RoseDaggerDev/GBAWii3-Boards/EastECHO/KiCad/Export/EastECHO-Edge_Cuts.dxf

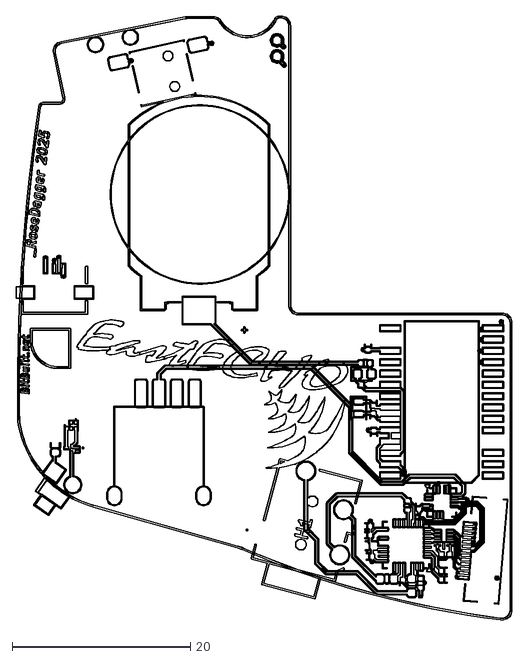
[picture p12: CAD file, 2025-09-09]
EastECHO/KiCad/Export/EastECHO-Edge_Cuts.dxf
55.6 x 67.7
