RoseDaggerDev/GBAWii3-Boards/EastECHO/KiCad/Outline.dxf

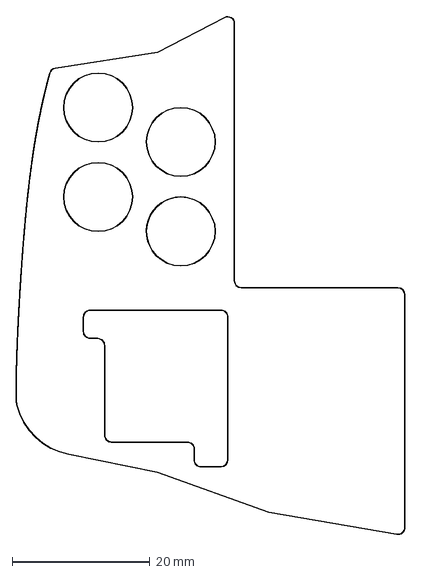
[picture p13: CAD file, 2025-09-04]
EastECHO/KiCad/Outline.dxf
56.5 x 75.3 mm
