RoseDaggerDev/GBAWii3-Boards/GhostPAW/KiCad/MelonLORD.dxf

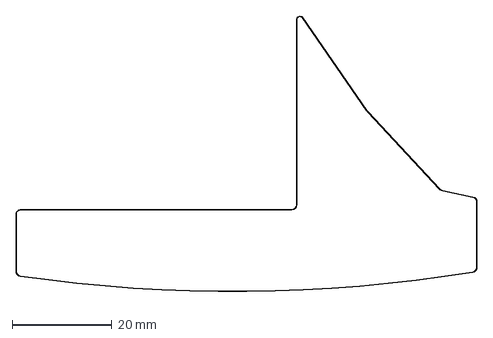
[picture p14: CAD file, 2025-09-04]
GhostPAW/KiCad/MelonLORD.dxf
92.4 x 56.5 mm
