RoseDaggerDev/GBAWii3-Boards/MelonLORD/KiCad/Outline.dxf

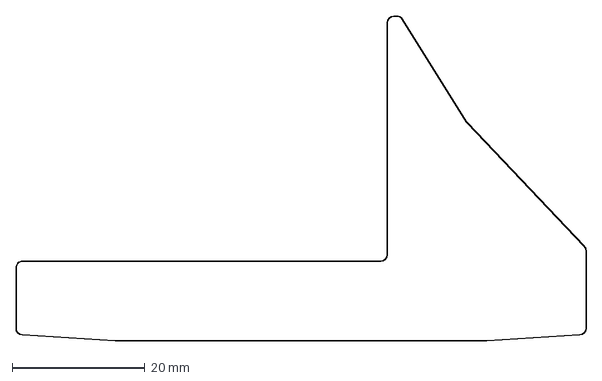
[picture p15: CAD file, 2025-09-04]
MelonLORD/KiCad/Outline.dxf
86.0 x 49.0 mm
