RoseDaggerDev/GBAWii3-Boards/EastECHO/KiCad/EastECHO.step

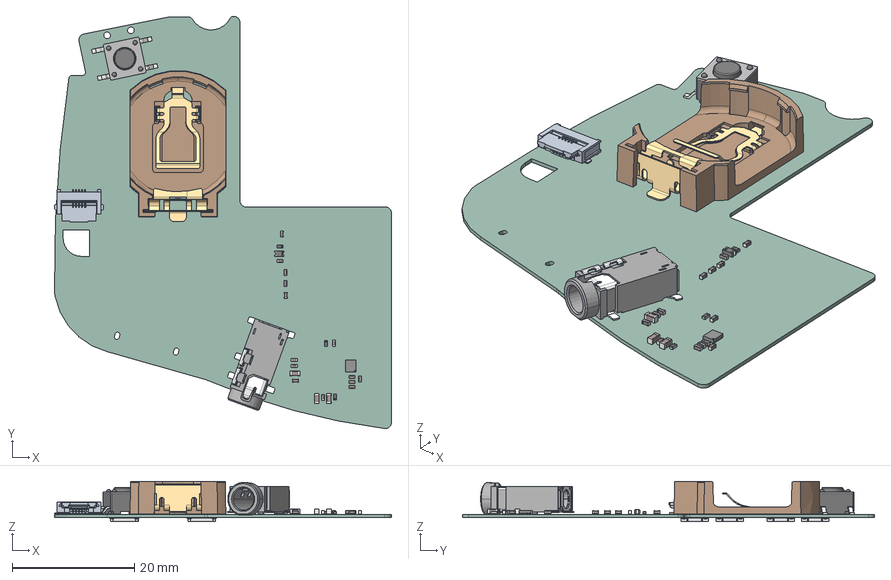
[picture p16: CAD file, 2025-09-04]
EastECHO/KiCad/EastECHO.step
55.2 x 67.5 x 6.58 mm
C_0603_1608Metric x 3
R_0402_1005Metric x 3
C_0402_1005Metric x 14
SJ2-35364B-SMT-TR
TXU0104RUTR
SW_Push_1P1T_NO_E-Switch_TL3301NxxxxxG
D_0603_1608Metric
TL3315NF100Q x 4
EastECHO_PCB
