RoseDaggerDev/GBAWii3-Boards/GhostPAW/KiCad/Export/GhostPAW-Edge_Cuts.dxf

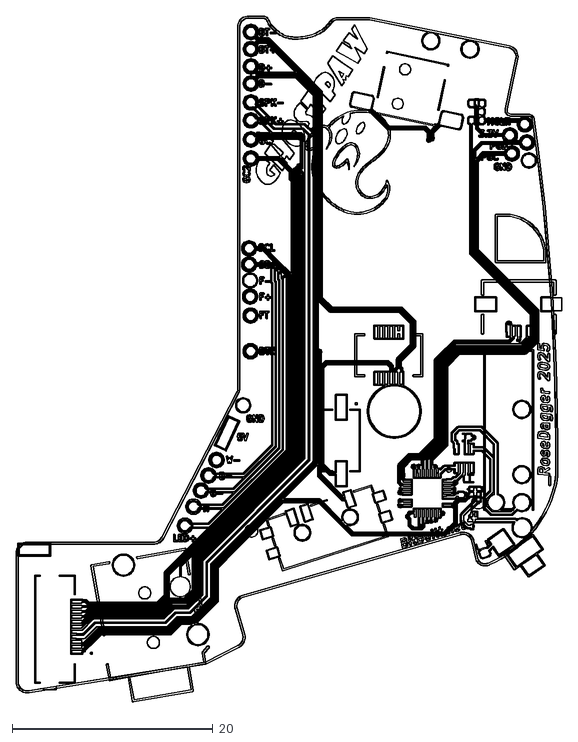
[picture p17: CAD file, 2025-09-09]
GhostPAW/KiCad/Export/GhostPAW-Edge_Cuts.dxf
54.4 x 68.3
