RoseDaggerDev/GBAWii3-Boards/GhostPAW/KiCad/Outline.dxf

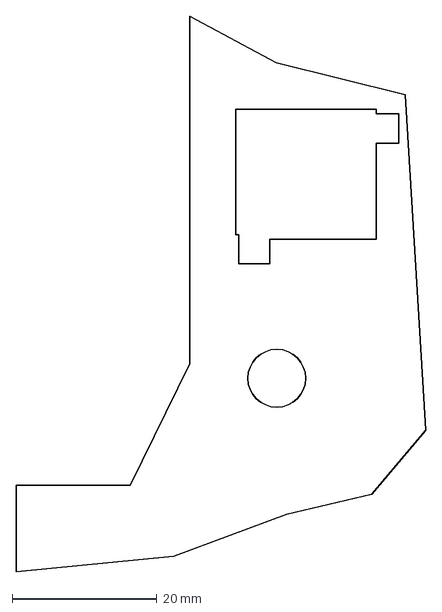
[picture p18: CAD file, 2025-09-04]
GhostPAW/KiCad/Outline.dxf
56.5 x 76.7 mm
