RoseDaggerDev/GBAWii3-Boards/MelonLORD/KiCad/Export/MelonLORD-Edge_Cuts.dxf

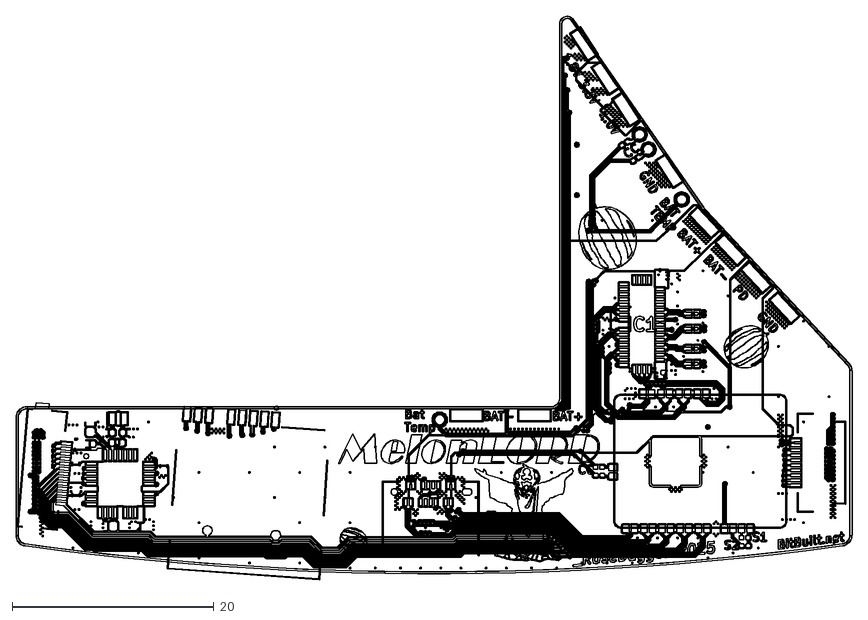
[picture p19: CAD file, 2025-09-04]
MelonLORD/KiCad/Export/MelonLORD-Edge_Cuts.dxf
82.9 x 55.9
