RoseDaggerDev/GBAWii3-Boards/(list of files, cad)

Other CAD files:
GhostPAW/KiCad/Export/GhostPAW.stl
MelonLORD/KiCad/Export/MelonLORD.stl
EastECHO/KiCad/EastECHO.stl
EastECHO/KiCad/Export/EastECHO.stl
GhostPAW/KiCad/Export/GhostPAW-B_Mask.dxf
GhostPAW/KiCad/GhostPAW.stl
MelonLORD/KiCad/MelonLORD-Edge_Cuts.dxf
MelonLORD/KiCad/MelonLORD.stl
