RoseDaggerDev/GBAWii3-Boards/EastECHO/KiCad/Export/EastECHO-Edge_Cuts.pdf

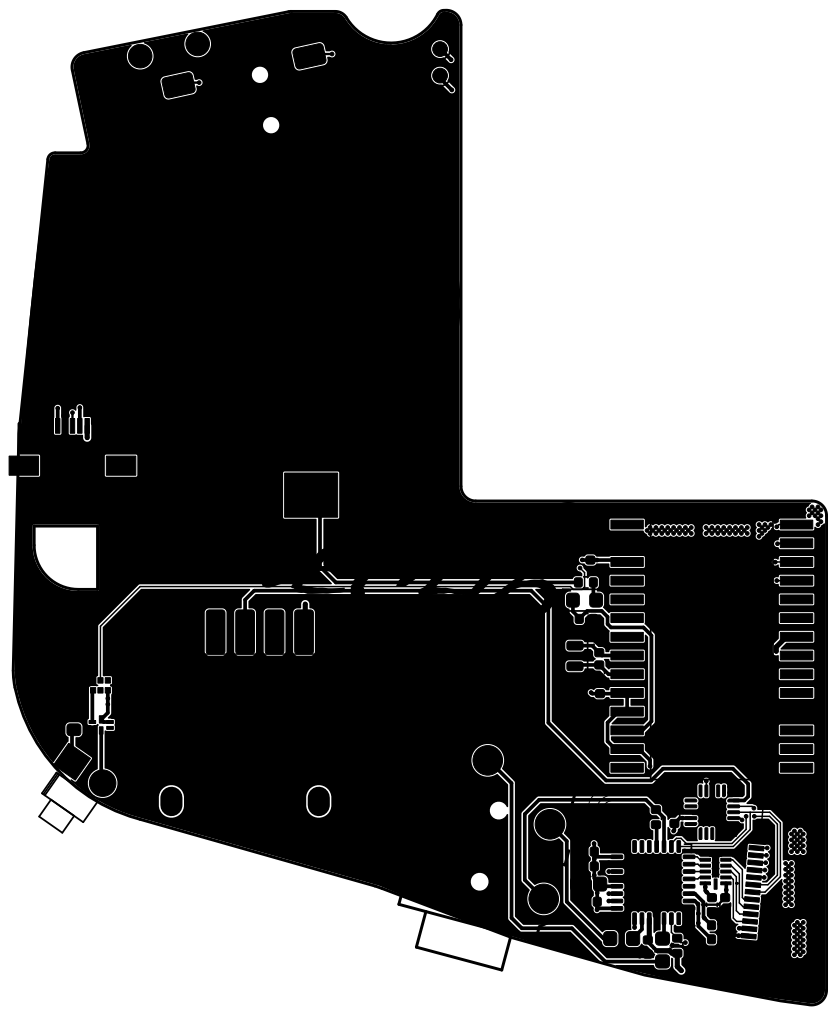
[picture p20: page 1]
