RoseDaggerDev/GBAWii3-Boards/EastECHO/KiCad/Export/EchoEAST.pdf

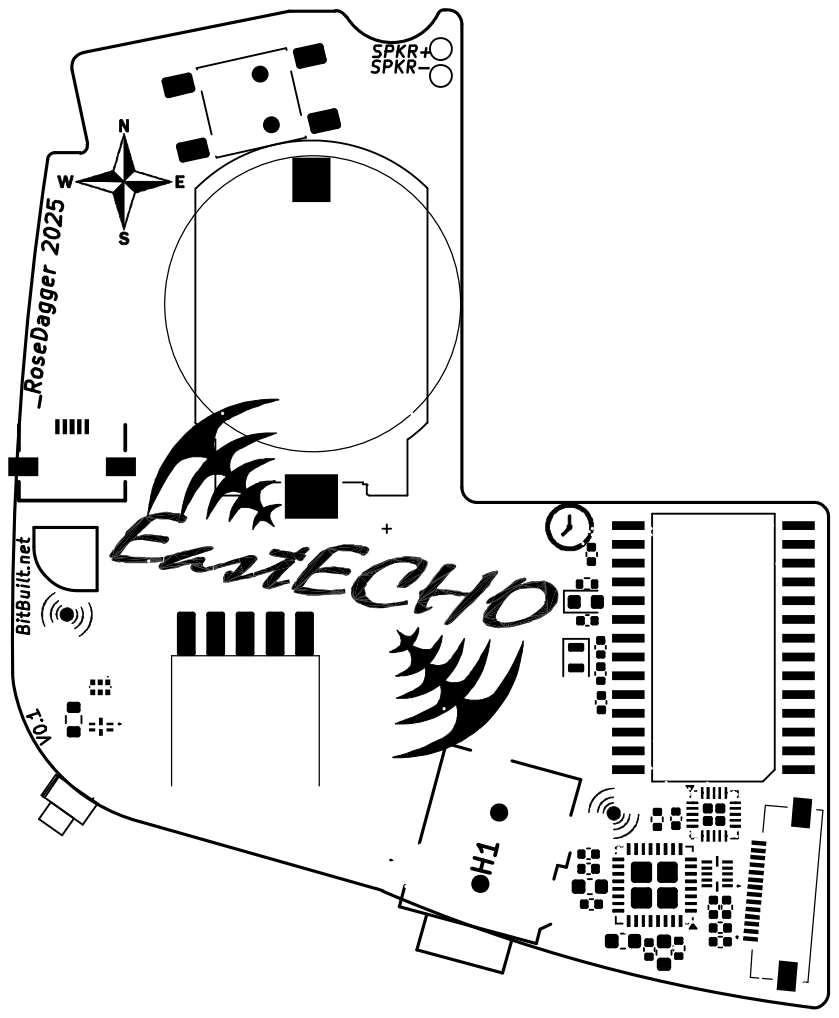
[picture p21: page 1]
