RoseDaggerDev/GBAWii3-Boards/GhostPAW/KiCad/Export/GhostPAW.pdf

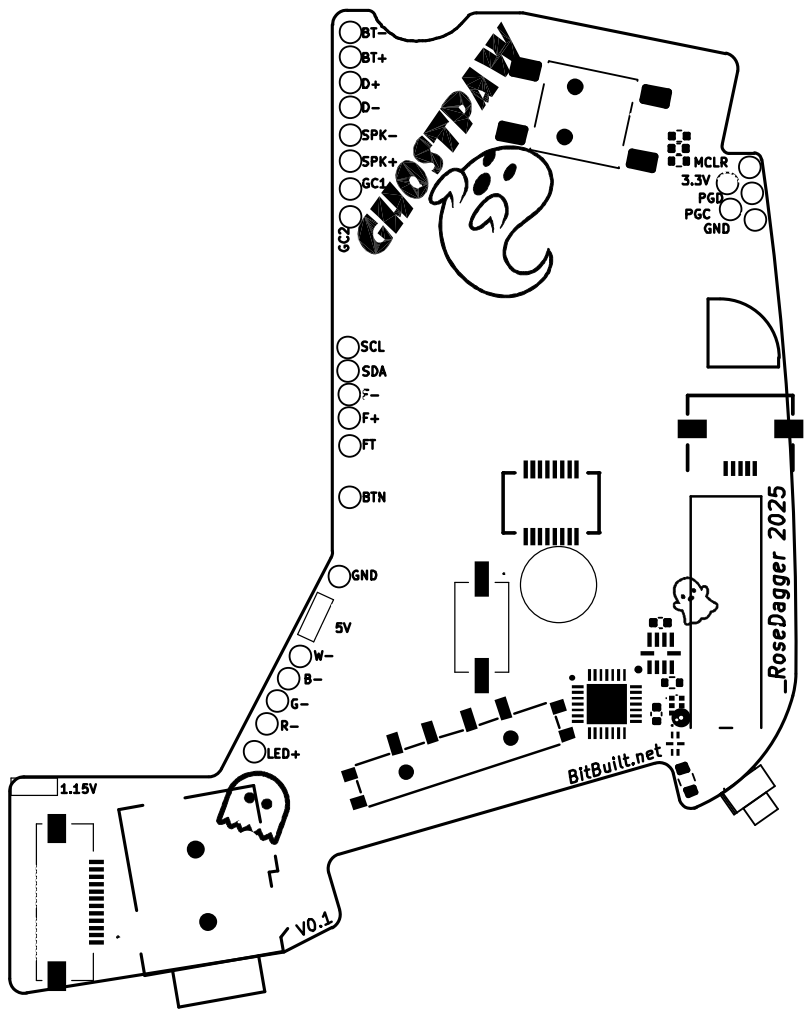
[picture p22: page 1]
