RoseDaggerDev/GBAWii3-Boards/MelonLORD/KiCad/Export/MelonLORD.pdf

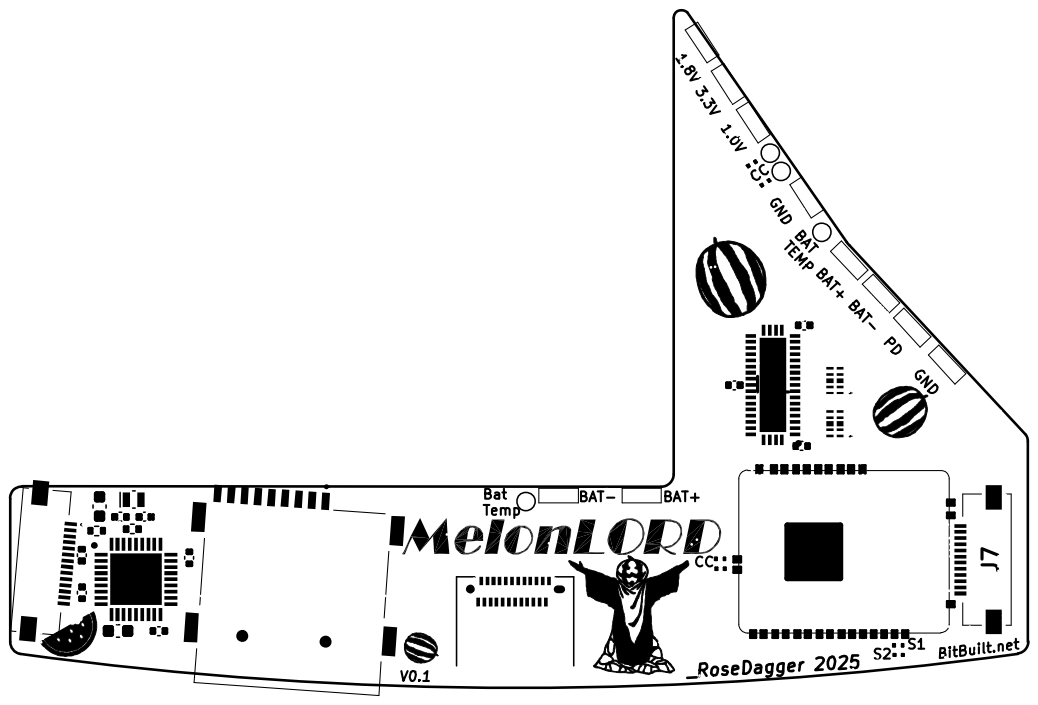
[picture p23: page 1]
