RoseDaggerDev/GBAWii3-Boards/EastECHO/KiCad/EastECHO.kicad_sch

## KiCad design EastECHO/KiCad/EastECHO.kicad_sch (2025-09-04)

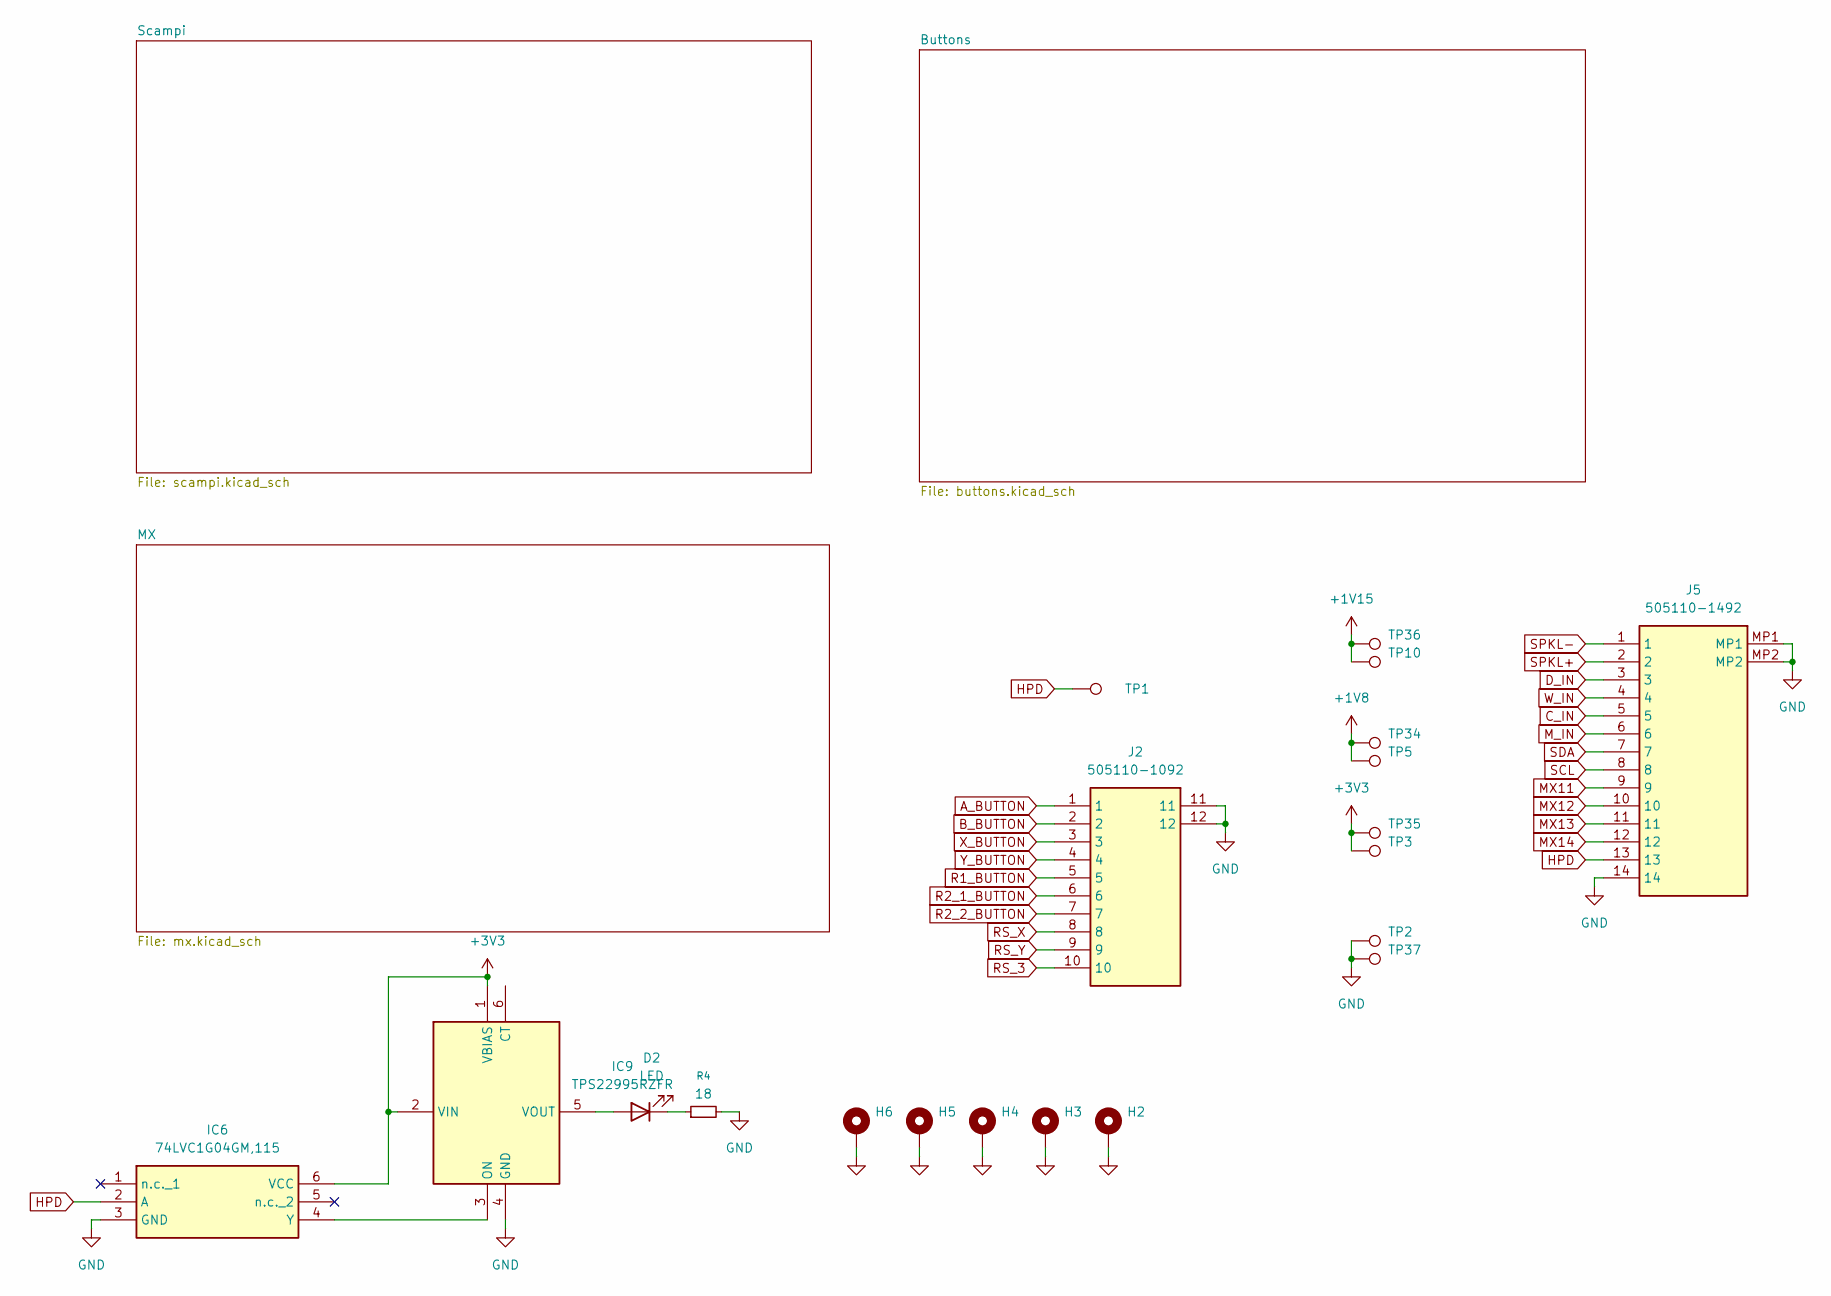
[picture p24: schematic EastECHO.kicad_sch]

Parts:
D2: LED; LED_D1.8mm_W1.8mm_H2.4mm_Horizontal_O1.27mm_Z8.2mm
H2, H3, H4, H5, H6: MountingHole_Pad; MountingHole_2.2mm_M2_DIN965_Pad
IC6: 74LVC1G04GM,115; PESD3V3L5UF115; Mouser Part Number 771-LVC1G04GM115
IC9: TPS22995RZFR; Mouser Part Number 595-TPS22995RZFR
J2: 505110-1092; 5051101092; Mouser Part Number 538-505110-1092
J5: 505110-1492; 5051101492; Mouser Part Number 538-505110-1492
R4: 18; R_0603_1608Metric
TP1: SPKL-; TestPoint_Pad_D1.0mm
TP2, TP3, TP5, TP10, TP34, TP35, TP36, TP37: TestPoint; TestPoint_Pad_3x1.0mm

Connections:
+1V8: TP5.1, TP34.1
+1V15: TP10.1, TP36.1
+3V3: IC6.6 (VCC), IC9.1 (VBIAS), IC9.2 (VIN), TP3.1, TP35.1
A_BUTTON: J2.1
B_BUTTON: J2.2
C_IN: J5.5
D_IN: J5.3
GND: H2.1, H3.1, H4.1, H5.1, H6.1, IC6.3 (GND), IC9.4 (GND), J2.11, J2.12, J5.14, J5.MP1, J5.MP2, R4.2, TP2.1, TP37.1
HPD: IC6.2 (A), J5.13, TP1.1
MX11: J5.9
MX12: J5.10
MX13: J5.11
MX14: J5.12
M_IN: J5.6
unnamed: D2.1 (K), R4.1
unnamed: D2.2 (A), IC9.5 (VOUT)
unnamed: IC6.4 (Y), IC9.3 (ON)
R1_BUTTON: J2.5
R2_1_BUTTON: J2.6
R2_2_BUTTON: J2.7
RS_3: J2.10
RS_X: J2.8
RS_Y: J2.9
SCL: J5.8
SDA: J5.7
SPKL+: J5.2
SPKL-: J5.1
W_IN: J5.4
X_BUTTON: J2.3
Y_BUTTON: J2.4
