RoseDaggerDev/GBAWii3-Boards/EastECHO/KiCad/buttons.kicad_sch

## KiCad design EastECHO/KiCad/buttons.kicad_sch (2025-09-04)

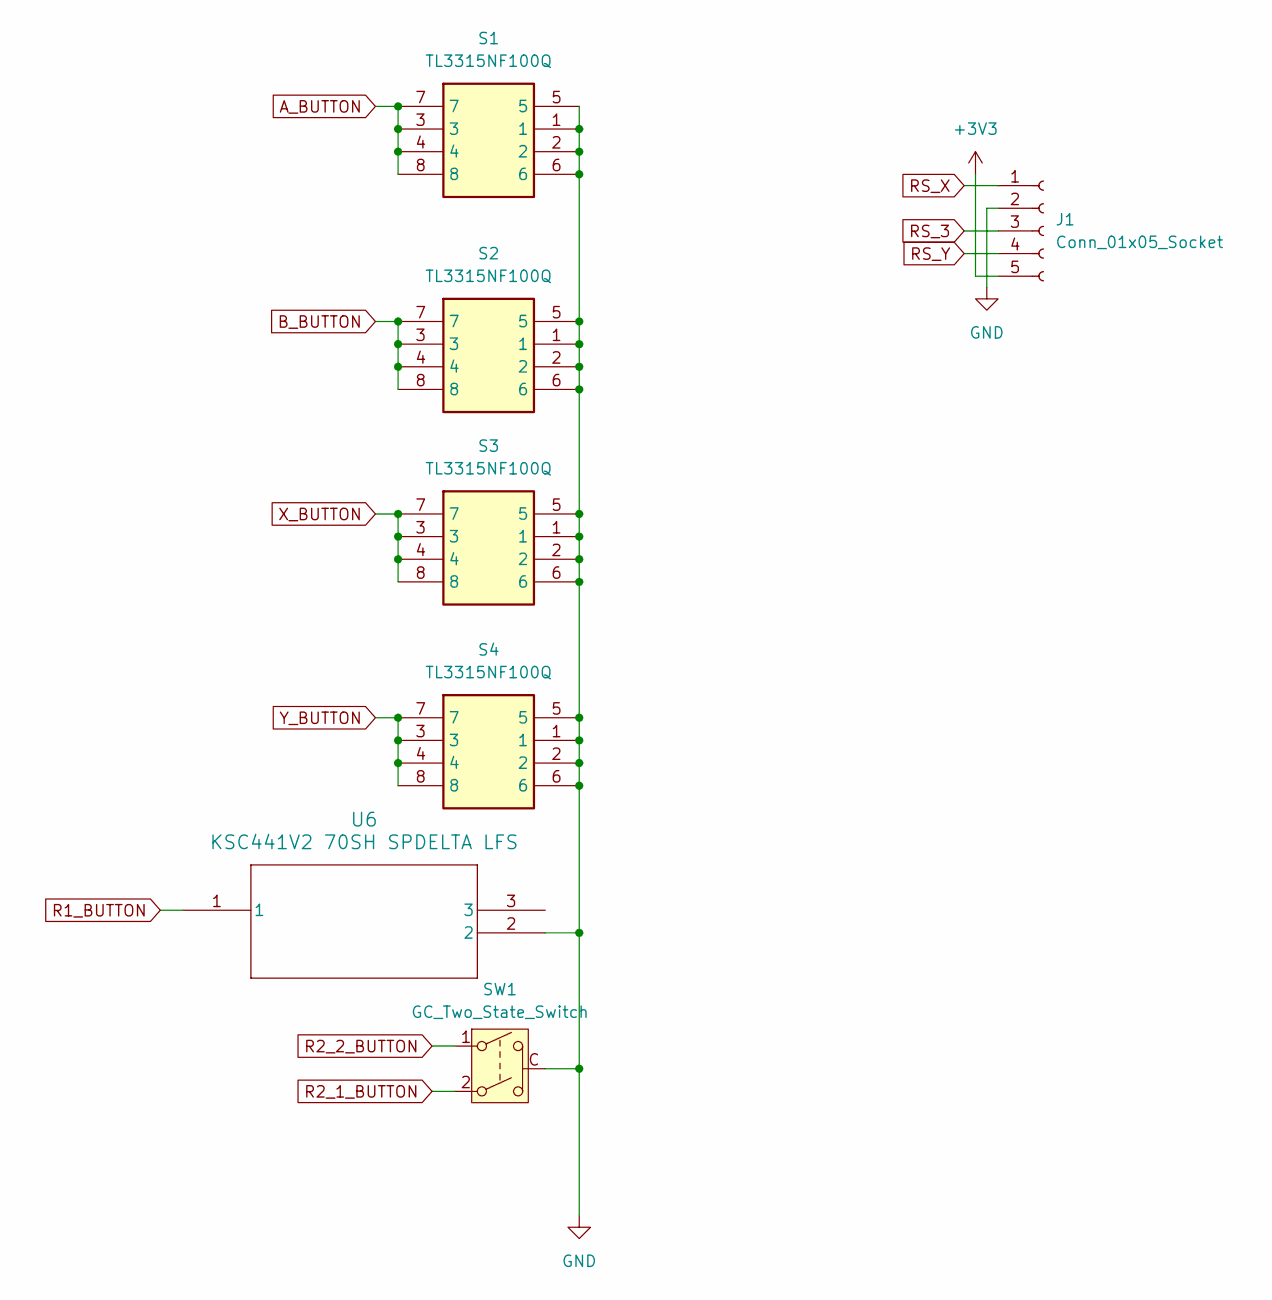
[picture p25: schematic buttons.kicad_sch]

Parts:
J1: Conn_01x05_Socket; 5051100592
S1, S2, S3, S4: TL3315NF100Q; Mouser Part Number 612-TL3315NF100Q
SW1: GC_Two_State_Switch; GC_Two_state_switch
U6: KSC441V2 70SH SPDELTA LFS; SW3_KSC441V2

Connections:
+3V3: J1.5
A_BUTTON: S1.3, S1.4, S1.7, S1.8
B_BUTTON: S2.3, S2.4, S2.7, S2.8
GND: J1.2, S1.1, S1.2, S1.5, S1.6, S2.1, S2.2, S2.5, S2.6, S3.1, S3.2, S3.5, S3.6, S4.1, S4.2, S4.5, S4.6, SW1.C, U6.2
R1_BUTTON: U6.1
R2_1_BUTTON: SW1.2
R2_2_BUTTON: SW1.1
RS_3: J1.3
RS_X: J1.1
RS_Y: J1.4
X_BUTTON: S3.3, S3.4, S3.7, S3.8
Y_BUTTON: S4.3, S4.4, S4.7, S4.8
