RoseDaggerDev/GBAWii3-Boards/EastECHO/KiCad/mx.kicad_sch

## KiCad design EastECHO/KiCad/mx.kicad_sch (2025-09-04)

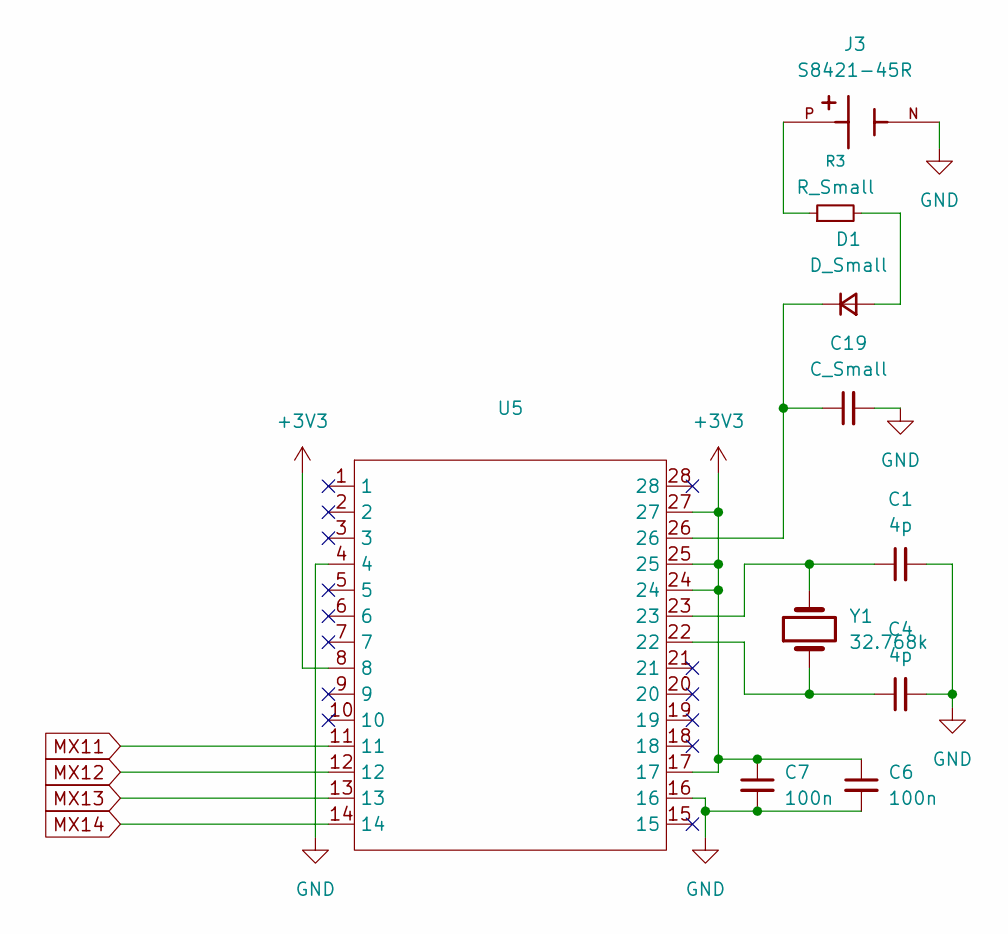
[picture p26: schematic mx.kicad_sch]

Parts:
C1, C4: 4p; C_0402_1005Metric
C6, C7: 100n; C_0402_1005Metric
C19: C_Small; C_0402_1005Metric
D1: D_Small; D_0603_1608Metric
J3: S8421-45R; HARWIN_S8421-45R; PARTREV 7
R3: R_Small; R_0402_1005Metric
U5: MX_CHIP
Y1: 32.768k; Crystal_SMD_2012-2Pin_2.0x1.2mm

Connections:
+3V3: C6.1, C7.1, U5.8, U5.17, U5.24, U5.25, U5.27
GND: C1.2, C4.2, C6.2, C7.2, C19.2, J3.N, U5.4, U5.16
MX11: U5.11
MX12: U5.12
MX13: U5.13
MX14: U5.14
unnamed: C1.1, U5.23, Y1.2
unnamed: C4.1, U5.22, Y1.1
unnamed: C19.1, D1.1 (K), U5.26
unnamed: D1.2 (A), R3.2
unnamed: J3.P, R3.1
