RoseDaggerDev/GBAWii3-Boards/EastECHO/KiCad/scampi.kicad_sch

## KiCad design EastECHO/KiCad/scampi.kicad_sch (2025-09-04)

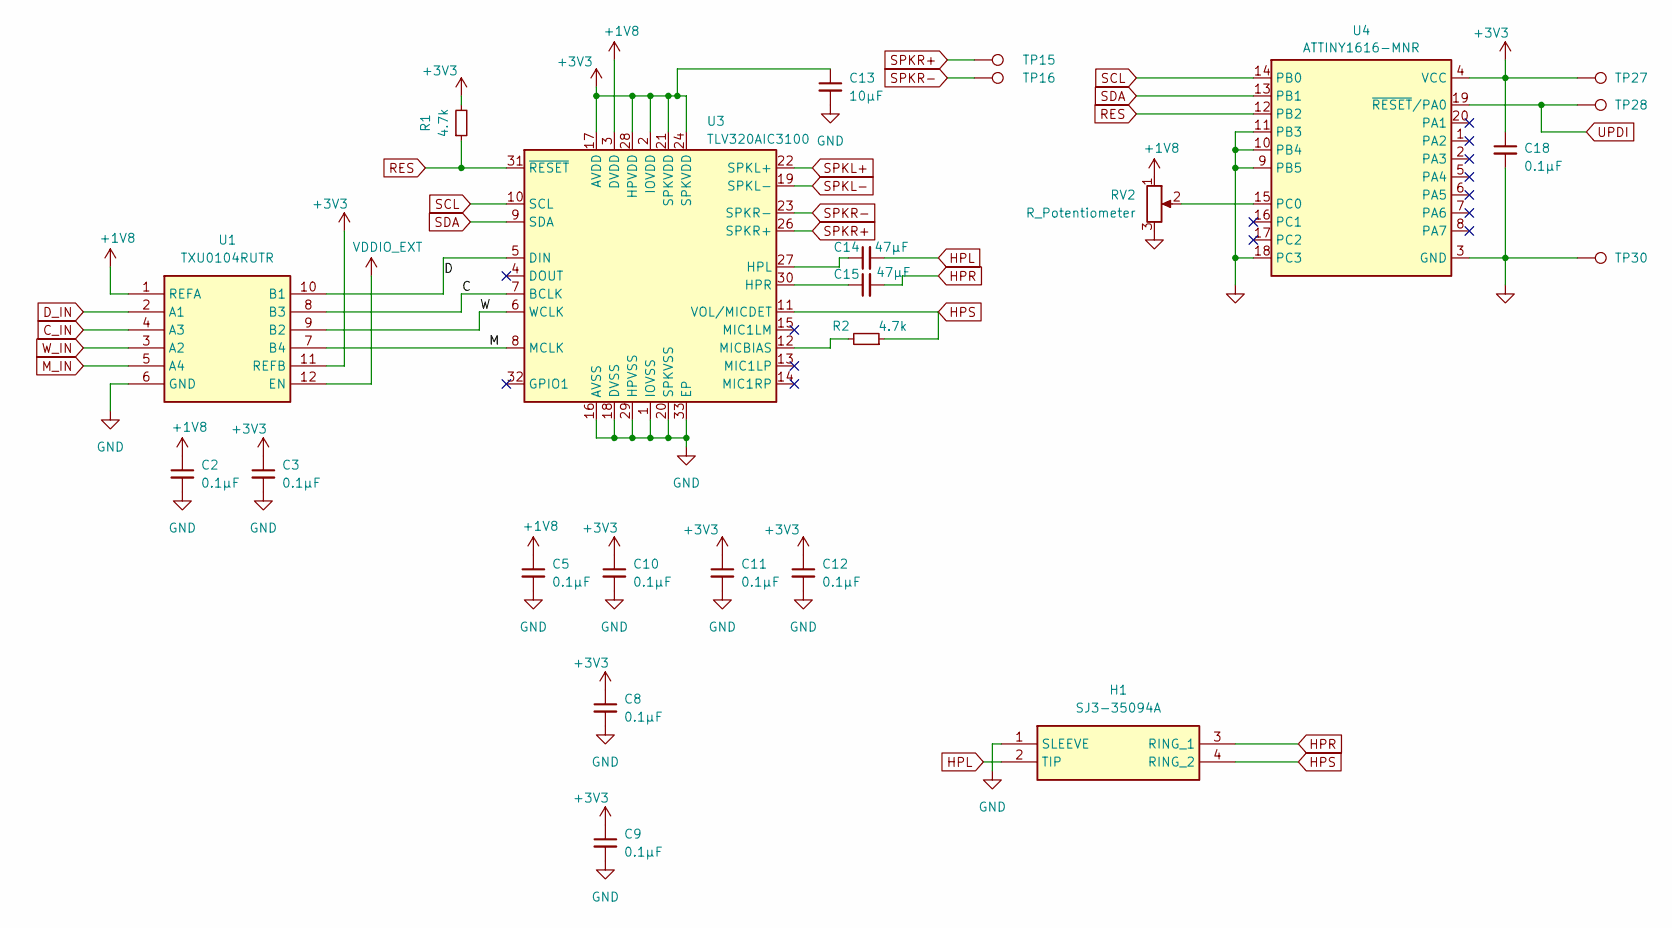
[picture p27: schematic scampi.kicad_sch]

Parts:
C2, C3, C5, C8, C9, C10, C11, C12, C18: 0.1µF; C_0402_1005Metric
C13: 10µF; C_0603_1608Metric
C14, C15: 47µF; C_0603_1608Metric
H1: SJ3-35094A; SJ335094A; Mouser Part Number 179-SJ3-35094A
R1, R2: 4.7k; R_0402_1005Metric
RV2: R_Potentiometer; B103_Potentiometer
TP15: SPKR-; TestPoint_Pad_D1.0mm
TP16: SPKR+; TestPoint_Pad_D1.0mm
TP27: 3.3V; TestPoint_Pad_D1.0mm
TP28: UPDI; TestPoint_Pad_D1.0mm
TP30: GND; TestPoint_Pad_D1.0mm
U1: TXU0104RUTR; Mouser Part Number TXU0104RUTR
U3: TLV320AIC3100; VQFN-32-1EP_5x5mm_P0.5mm_EP3.5x3.5mm
U4: ATTINY1616-MNR; VQFN-20-1EP_3x3mm_P0.4mm_EP1.7x1.7mm

Connections:
+1V8: C2.1, C5.1, RV2.1, U1.1 (REFA), U3.3 (DVDD)
+3V3: C3.1, C8.1, C9.1, C10.1, C11.1, C12.1, C13.1, C18.1, R1.2, TP27.1, U1.11 (REFB), U3.2 (IOVDD), U3.17 (AVDD), U3.21 (SPKVDD), U3.24 (SPKVDD), U3.28 (HPVDD), U4.4 (VCC)
C: U1.8 (B3), U3.7 (BCLK)
C_IN: U1.4 (A3)
D: U1.10 (B1), U3.5 (DIN)
D_IN: U1.2 (A1)
GND: C2.2, C3.2, C5.2, C8.2, C9.2, C10.2, C11.2, C12.2, C13.2, C18.2, H1.1 (SLEEVE), RV2.3, TP30.1, U1.6 (GND), U3.1 (IOVSS), U3.16 (AVSS), U3.18 (DVSS), U3.20 (SPKVSS), U3.25 (SPKVSS), U3.29 (HPVSS), U3.33 (EP), U4.3 (GND), U4.9 (PB5), U4.10 (PB4), U4.11 (PB3), U4.18 (PC3), U4.21 (GND)
HPL: C14.2, H1.2 (TIP)
HPR: C15.2, H1.3 (RING_1)
HPS: H1.4 (RING_2), R2.1, U3.11 (VOL/MICDET)
M: U1.7 (B4), U3.8 (MCLK)
M_IN: U1.5 (A4)
unnamed: C14.1, U3.27 (HPL)
unnamed: C15.1, U3.30 (HPR)
unnamed: R2.2, U3.12 (MICBIAS)
unnamed: RV2.2, U4.15 (PC0)
RES: R1.1, U3.31 (~RESET), U4.12 (PB2)
SCL: U3.10 (SCL), U4.14 (PB0)
SDA: U3.9 (SDA), U4.13 (PB1)
SPKL+: U3.22 (SPKL+)
SPKL-: U3.19 (SPKL-)
SPKR+: TP15.1, U3.26 (SPKR+)
SPKR-: TP16.1, U3.23 (SPKR-)
UPDI: TP28.1, U4.19 (~RESET/PA0)
VDDIO_EXT: U1.12 (EN)
W: U1.9 (B2), U3.6 (WCLK)
W_IN: U1.3 (A2)
