RoseDaggerDev/GBAWii3-Boards/GhostPAW/KiCad/GC2Plus.kicad_sch

## KiCad design GhostPAW/KiCad/GC2Plus.kicad_sch (2025-09-04)

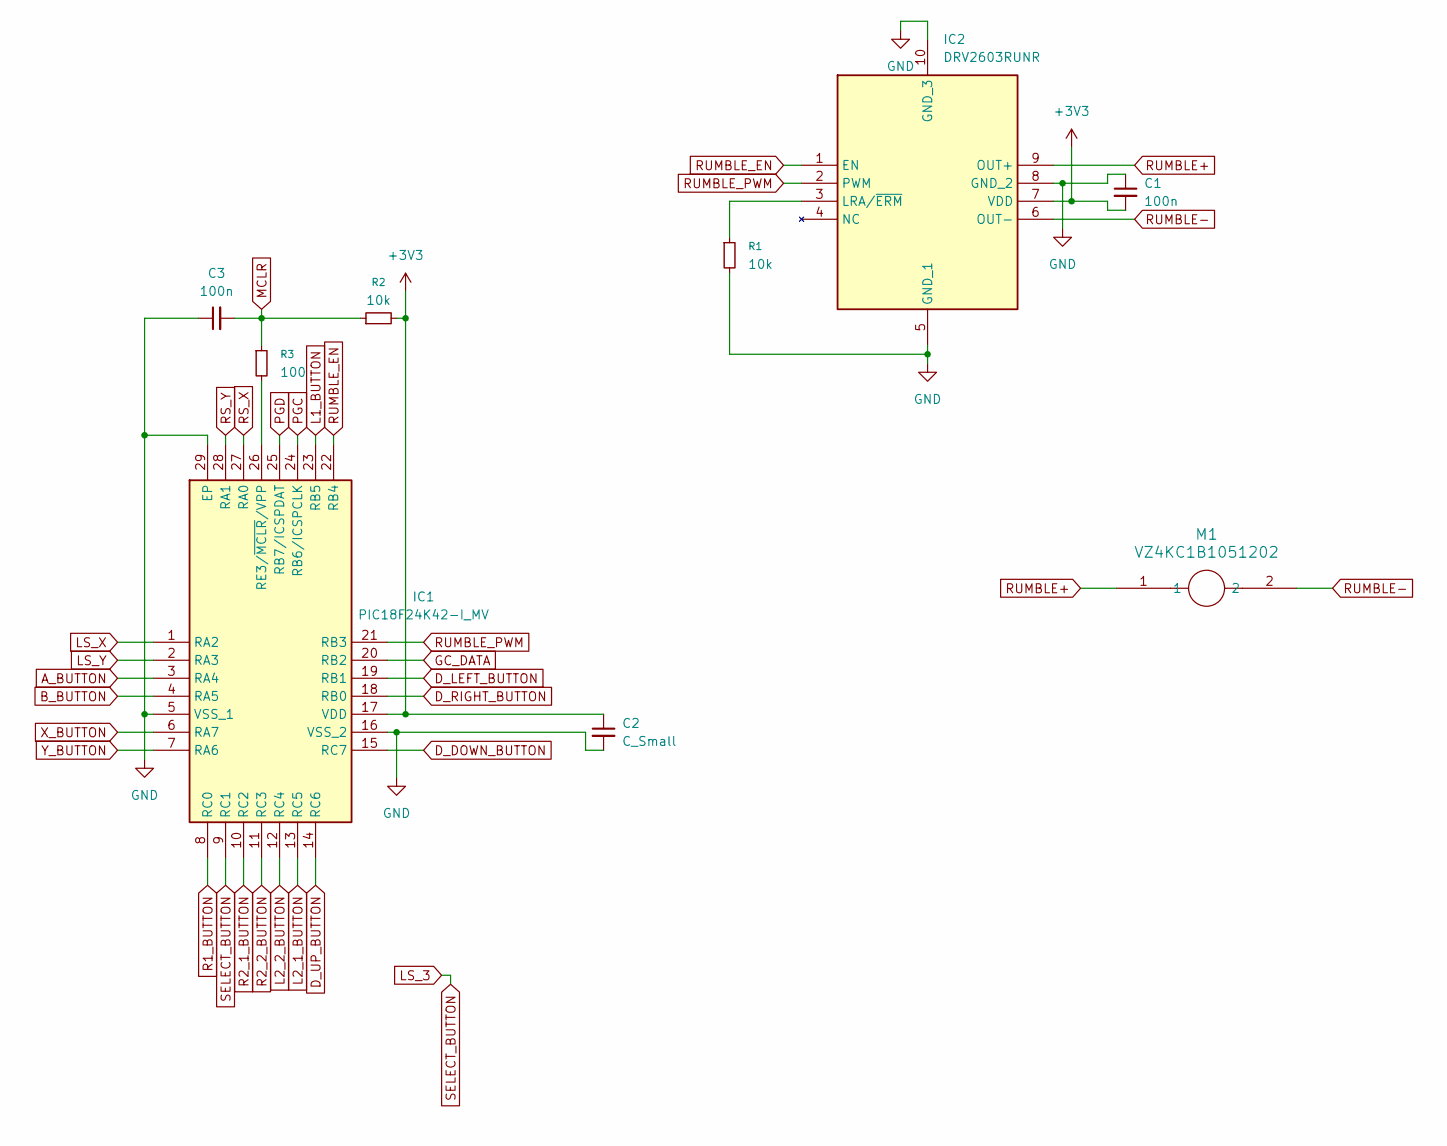
[picture p28: schematic GC2Plus.kicad_sch]

Parts:
C1, C3: 100n; C_0402_1005Metric
C2: C_Small; C_0402_1005Metric
IC1: PIC18F24K42-I_MV; QFN40P400X400X55-29N-D; Mouser Part Number 579-PIC18F24K42-I/MV
IC2: DRV2603RUNR; QFN50P200X200X80-10N-D; Mouser Part Number 595-DRV2603RUNR
M1: VZ4KC1B1051202; VZ4KC1B1051202_VYB
R1, R2: 10k; R_0402_1005Metric
R3: 100; R_0402_1005Metric

Connections:
+3V3: C1.2, C2.1, IC1.17 (VDD), IC2.7 (VDD), R2.2
A_BUTTON: IC1.3 (RA4)
B_BUTTON: IC1.4 (RA5)
D_DOWN_BUTTON: IC1.15 (RC7)
D_LEFT_BUTTON: IC1.19 (RB1)
D_RIGHT_BUTTON: IC1.18 (RB0)
D_UP_BUTTON: IC1.14 (RC6)
GC_DATA: IC1.20 (RB2)
GND: C1.1, C2.2, C3.1, IC1.5 (VSS_1), IC1.16 (VSS_2), IC1.29 (EP), IC2.5 (GND_1), IC2.8 (GND_2), IC2.10 (GND_3), R1.2
L1_BUTTON: IC1.23 (RB5)
L2_1_BUTTON: IC1.13 (RC5)
L2_2_BUTTON: IC1.12 (RC4)
LS_3: IC1.9 (RC1)
LS_X: IC1.1 (RA2)
LS_Y: IC1.2 (RA3)
MCLR: C3.2, R2.1, R3.1
unnamed: IC1.26 (RE3/~MCLR/VPP), R3.2
unnamed: IC2.3 (LRA/~ERM), R1.1
PGC: IC1.24 (RB6/ICSPCLK)
PGD: IC1.25 (RB7/ICSPDAT)
R1_BUTTON: IC1.8 (RC0)
R2_1_BUTTON: IC1.10 (RC2)
R2_2_BUTTON: IC1.11 (RC3)
RS_X: IC1.27 (RA0)
RS_Y: IC1.28 (RA1)
RUMBLE+: IC2.9 (OUT+), M1.1
RUMBLE-: IC2.6 (OUT-), M1.2
RUMBLE_EN: IC1.22 (RB4), IC2.1 (EN)
RUMBLE_PWM: IC1.21 (RB3), IC2.2 (PWM)
X_BUTTON: IC1.6 (RA7)
Y_BUTTON: IC1.7 (RA6)
