RoseDaggerDev/GBAWii3-Boards/GhostPAW/KiCad/GhostPAW.kicad_sch

## KiCad design GhostPAW/KiCad/GhostPAW.kicad_sch (2025-09-09)

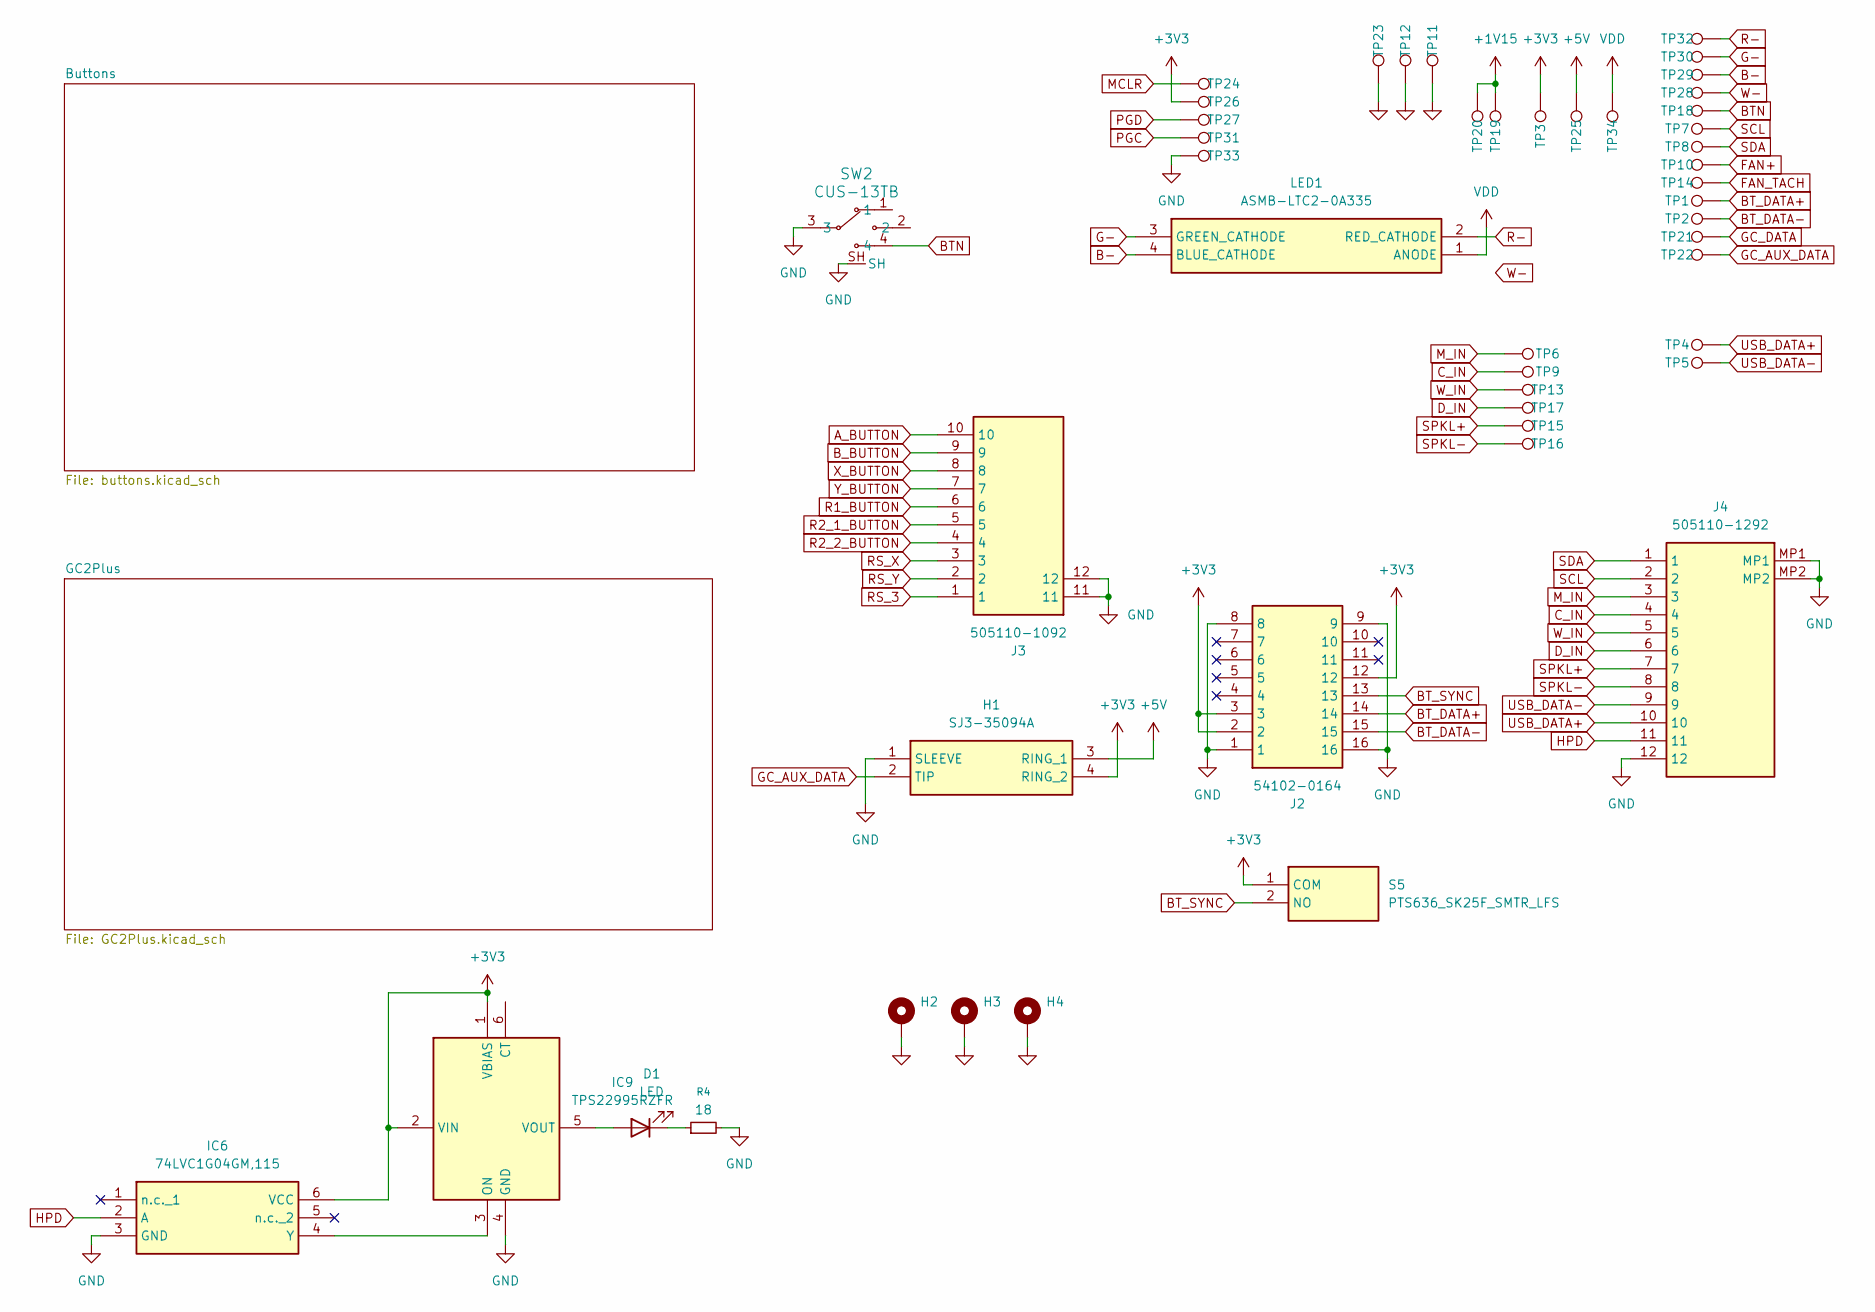
[picture p29: schematic GhostPAW.kicad_sch]

Parts:
D1: LED; LED_D1.8mm_W1.8mm_H2.4mm_Horizontal_O1.27mm_Z8.2mm
H1: SJ3-35094A; SJ335094A; Mouser Part Number 179-SJ3-35094A
H2, H3, H4: MountingHole_Pad; MountingHole_2.2mm_M2_DIN965_Pad
IC6: 74LVC1G04GM,115; PESD3V3L5UF115; Mouser Part Number 771-LVC1G04GM115
IC9: TPS22995RZFR; Mouser Part Number 595-TPS22995RZFR
J2: 54102-0164; 541020164; Mouser Part Number 538-54102-0164
J3: 505110-1092; 5051101092; Mouser Part Number 538-505110-1092
J4: 505110-1292; 5051101292; Mouser Part Number 538-505110-1292
LED1: ASMB-LTC2-0A335; ASMBLTC20A335; Mouser Part Number 630-ASMB-LTC2-0A335
R4: 18; R_0603_1608Metric
S5: PTS636_SK25F_SMTR_LFS; PTS636SK25FSMTRLFS; Mouser Part Number 611-PTS636SK25FSMTRL
SW2: CUS-13TB; CUS-13TB_NDC
TP1, TP4, TP6, TP9, TP13, TP15, TP16, TP17, TP24, TP26, TP27, TP31, TP32, TP33: LED -R; TestPoint_Pad_D1.0mm
TP2, TP5, TP21, TP22, TP30: LED -G; TestPoint_Pad_D1.0mm
TP3, TP11, TP19, TP20, TP25: 5V; TestPoint_Pad_3x1.0mm
TP7: SCL; TestPoint_Pad_D1.0mm
TP8: SDA; TestPoint_Pad_D1.0mm
TP10: FAN+; TestPoint_Pad_D1.0mm
TP12: FAN-; TestPoint_Pad_D1.0mm
TP14: FAN_TACH; TestPoint_Pad_D1.0mm
TP18: BTN; TestPoint_Pad_D1.0mm
TP23: U10; TestPoint_Pad_D1.0mm
TP28: LED -W; TestPoint_Pad_D1.0mm
TP29: LED -B; TestPoint_Pad_D1.0mm
TP34: LED +; TestPoint_Pad_D1.0mm

Connections:
+1V15: TP19.1, TP20.1
+3V3: H1.4 (RING_2), IC6.6 (VCC), IC9.1 (VBIAS), IC9.2 (VIN), J2.2, J2.3, J2.12, S5.1 (COM), TP3.1, TP26.1
+5V: H1.3 (RING_1), TP25.1
A_BUTTON: J3.10
B-: LED1.4 (BLUE_CATHODE), TP29.1
BTN: SW2.4, TP18.1
BT_DATA+: J2.14, TP1.1
BT_DATA-: J2.15, TP2.1
BT_SYNC: J2.13, S5.2 (NO)
B_BUTTON: J3.9
C_IN: J4.4, TP9.1
D_IN: J4.6, TP17.1
FAN+: TP10.1
FAN_TACH: TP14.1
G-: LED1.3 (GREEN_CATHODE), TP30.1
GC_AUX_DATA: H1.2 (TIP), TP22.1
GC_DATA: TP21.1
GND: H1.1 (SLEEVE), H2.1, H3.1, H4.1, IC6.3 (GND), IC9.4 (GND), J2.1, J2.8, J2.9, J2.16, J3.11, J3.12, J4.12, J4.MP1, J4.MP2, R4.2, SW2.3, SW2.SH, TP11.1, TP12.1, TP23.1, TP33.1
HPD: IC6.2 (A), J4.11
MCLR: TP24.1
M_IN: J4.3, TP6.1
unnamed: D1.1 (K), R4.1
unnamed: D1.2 (A), IC9.5 (VOUT)
unnamed: IC6.4 (Y), IC9.3 (ON)
PGC: TP31.1
PGD: TP27.1
R1_BUTTON: J3.6
R2_1_BUTTON: J3.5
R2_2_BUTTON: J3.4
R-: LED1.2 (RED_CATHODE), TP32.1
RS_3: J3.1
RS_X: J3.3
RS_Y: J3.2
SCL: J4.2, TP7.1
SDA: J4.1, TP8.1
SPKL+: J4.7, TP15.1
SPKL-: J4.8, TP16.1
USB_DATA+: J4.10, TP4.1
USB_DATA-: J4.9, TP5.1
VDD: LED1.1 (ANODE), TP34.1
W-: TP28.1
W_IN: J4.5, TP13.1
X_BUTTON: J3.8
Y_BUTTON: J3.7
