RoseDaggerDev/GBAWii3-Boards/MelonLORD/KiCad/MelonLORD.kicad_sch

## KiCad design MelonLORD/KiCad/MelonLORD.kicad_sch (2025-09-04)

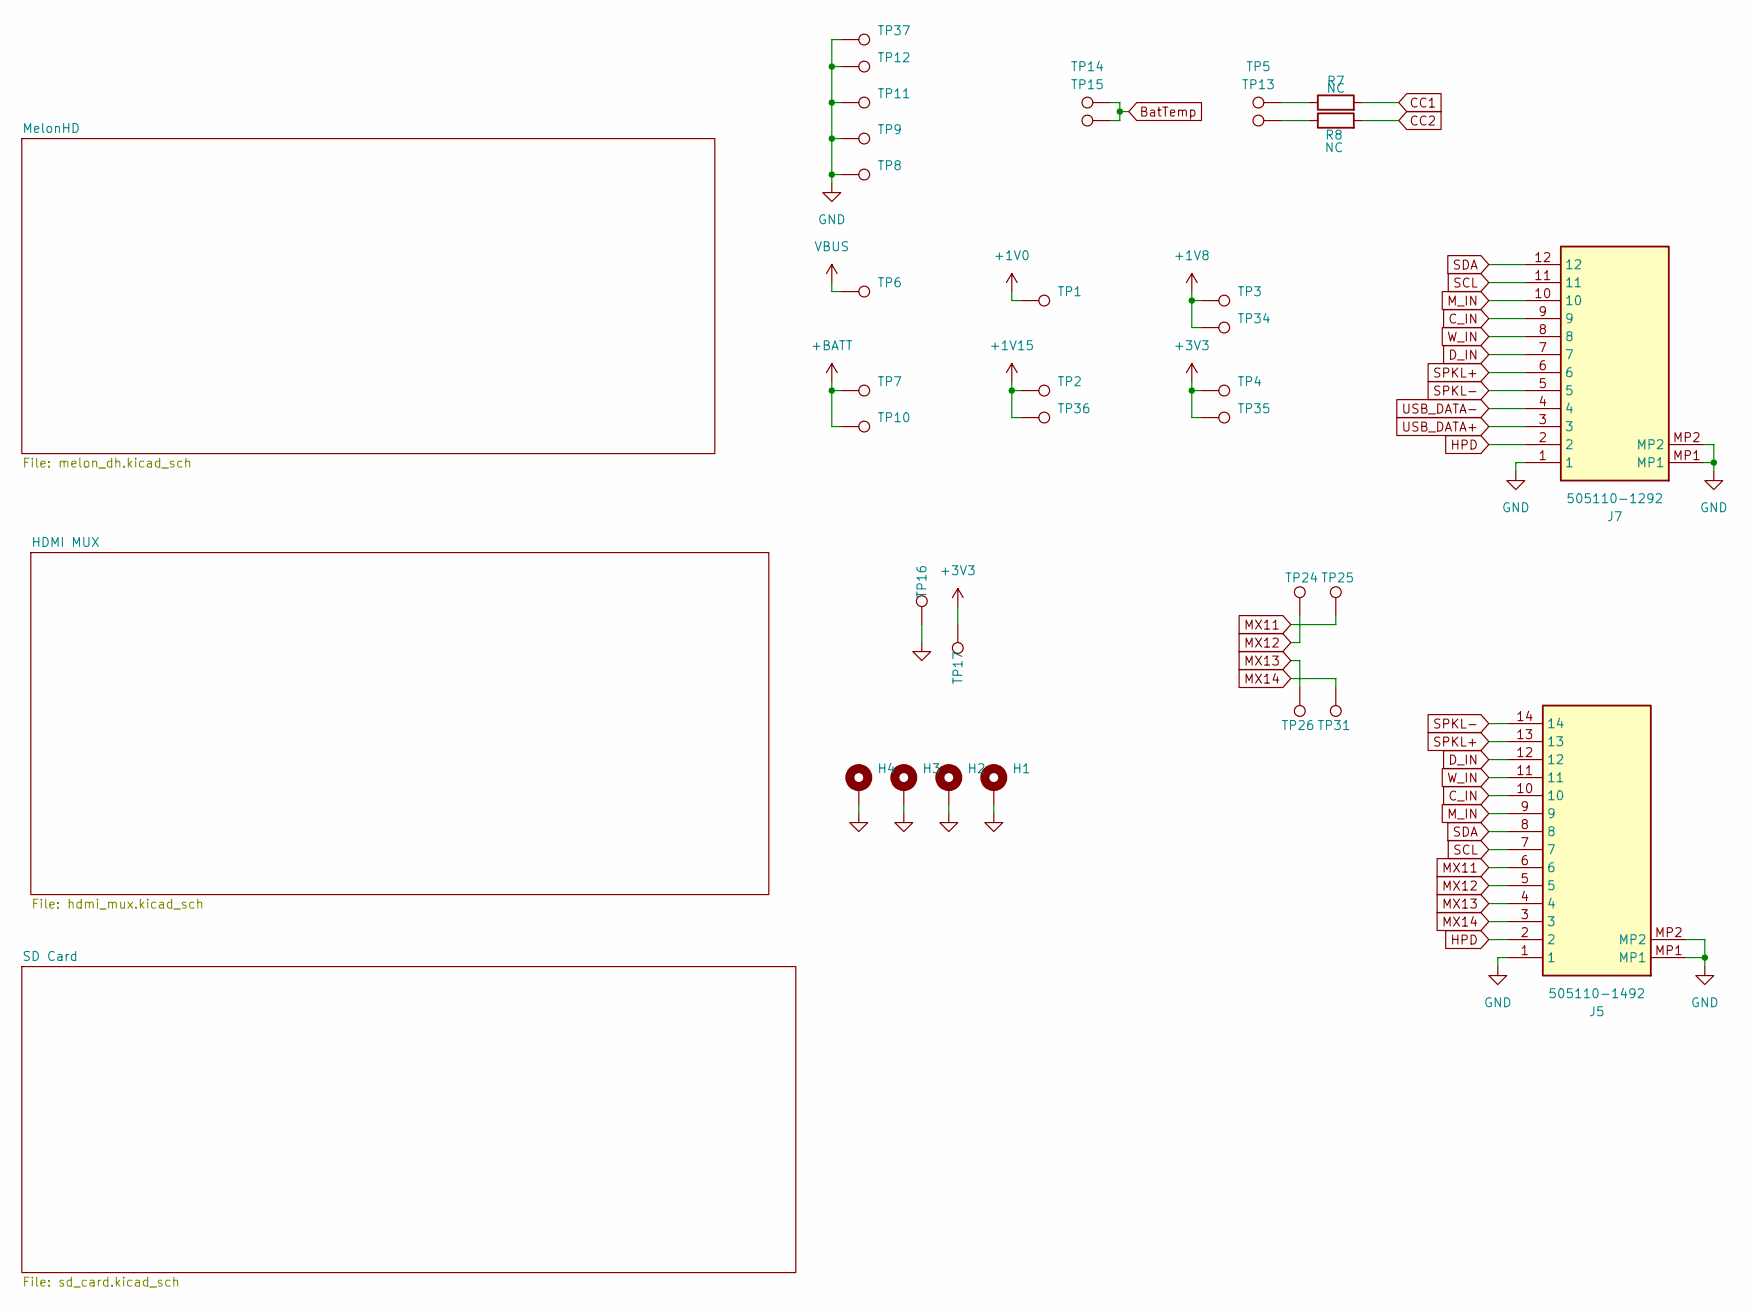
[picture p30: schematic MelonLORD.kicad_sch]

Parts:
H1, H2, H3, H4: MountingHole_Pad; MountingHole_2.2mm_M2_DIN965_Pad
J5: 505110-1492; 5051101492; Mouser Part Number 538-505110-1492
J7: 505110-1292; 5051101292; Mouser Part Number 538-505110-1292
R7, R8: NC; R_0201_0603Metric
TP1, TP2, TP3, TP4, TP6, TP7, TP8, TP9, TP10, TP11, TP12, TP34, TP35, TP36, TP37: TestPoint; TestPoint_Pad_3x1.0mm
TP5, TP13, TP14, TP15: TestPoint; TestPoint_Pad_D1.0mm
TP16, TP17: 5V; TestPoint_Pad_3x1.0mm
TP24, TP25, TP26, TP31: SPVDD; TestPoint_Pad_D1.0mm

Connections:
+1V0: TP1.1
+1V8: TP3.1, TP34.1
+1V15: TP2.1, TP36.1
+3V3: TP4.1, TP17.1, TP35.1
+BATT: TP7.1, TP10.1
BatTemp: TP14.1, TP15.1
CC1: R7.2
CC2: R8.2
C_IN: J5.10, J7.9
D_IN: J5.12, J7.7
GND: H1.1, H2.1, H3.1, H4.1, J5.1, J5.MP1, J5.MP2, J7.1, J7.MP1, J7.MP2, TP8.1, TP9.1, TP11.1, TP12.1, TP16.1, TP37.1
HPD: J5.2, J7.2
MX11: J5.6, TP25.1
MX12: J5.5, TP24.1
MX13: J5.4, TP26.1
MX14: J5.3, TP31.1
M_IN: J5.9, J7.10
unnamed: R7.1, TP5.1
unnamed: R8.1, TP13.1
SCL: J5.7, J7.11
SDA: J5.8, J7.12
SPKL+: J5.13, J7.6
SPKL-: J5.14, J7.5
USB_DATA+: J7.3
USB_DATA-: J7.4
VBUS: TP6.1
W_IN: J5.11, J7.8
