RoseDaggerDev/GBAWii3-Boards/MelonLORD/KiCad/hdmi_mux.kicad_sch

## KiCad design MelonLORD/KiCad/hdmi_mux.kicad_sch (2025-09-04)

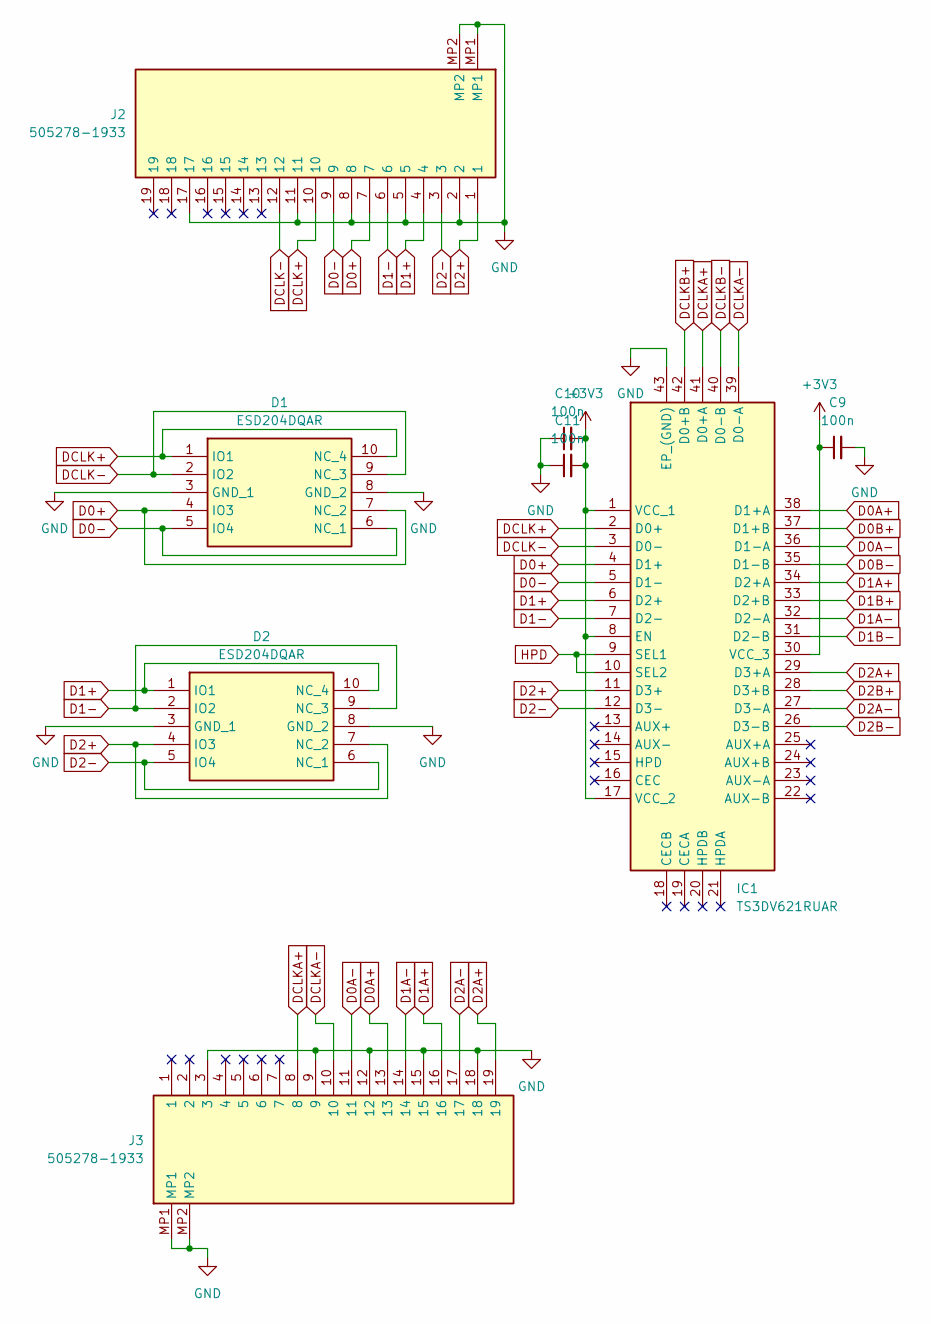
[picture p31: schematic hdmi_mux.kicad_sch]

Parts:
C9, C10, C11: 100n; C_0402_1005Metric
D1, D2: ESD204DQAR; Mouser Part Number 595-ESD204DQAR
IC1: TS3DV621RUAR; QFN50P350X900X80-43N-D; Mouser Part Number 595-TS3DV621RUAR
J2, J3: 505278-1933; 5052781933; Mouser Part Number 538-505278-1933

Connections:
+3V3: C9.1, C10.2, C11.2, IC1.1 (VCC_1), IC1.8 (EN), IC1.17 (VCC_2), IC1.30 (VCC_3)
D0+: D1.4 (IO3), D1.7 (NC_2), IC1.4 (D1+), J2.7
D0-: D1.5 (IO4), D1.6 (NC_1), IC1.5 (D1-), J2.9
D0A+: IC1.38 (D1+A), J3.13
D0A-: IC1.36 (D1-A), J3.11
D0B+: IC1.37 (D1+B)
D0B-: IC1.35 (D1-B)
D1+: D2.1 (IO1), D2.10 (NC_4), IC1.6 (D2+), J2.4
D1-: D2.2 (IO2), D2.9 (NC_3), IC1.7 (D2-), J2.6
D1A+: IC1.34 (D2+A), J3.16
D1A-: IC1.32 (D2-A), J3.14
D1B+: IC1.33 (D2+B)
D1B-: IC1.31 (D2-B)
D2+: D2.4 (IO3), D2.7 (NC_2), IC1.11 (D3+), J2.1
D2-: D2.5 (IO4), D2.6 (NC_1), IC1.12 (D3-), J2.3
D2A+: IC1.29 (D3+A), J3.19
D2A-: IC1.27 (D3-A), J3.17
D2B+: IC1.28 (D3+B)
D2B-: IC1.26 (D3-B)
DCLK+: D1.1 (IO1), D1.10 (NC_4), IC1.2 (D0+), J2.10
DCLK-: D1.2 (IO2), D1.9 (NC_3), IC1.3 (D0-), J2.12
DCLKA+: IC1.41 (D0+A), J3.8
DCLKA-: IC1.39 (D0-A), J3.10
DCLKB+: IC1.42 (D0+B)
DCLKB-: IC1.40 (D0-B)
GND: C9.2, C10.1, C11.1, D1.3 (GND_1), D1.8 (GND_2), D2.3 (GND_1), D2.8 (GND_2), IC1.43 (EP_(GND)), J2.2, J2.5, J2.8, J2.11, J2.17, J2.MP1, J2.MP2, J3.3, J3.9, J3.12, J3.15, J3.18, J3.MP1, J3.MP2
HPD: IC1.9 (SEL1), IC1.10 (SEL2)
