RoseDaggerDev/GBAWii3-Boards/MelonLORD/KiCad/melon_dh.kicad_sch

## KiCad design MelonLORD/KiCad/melon_dh.kicad_sch (2025-09-04)

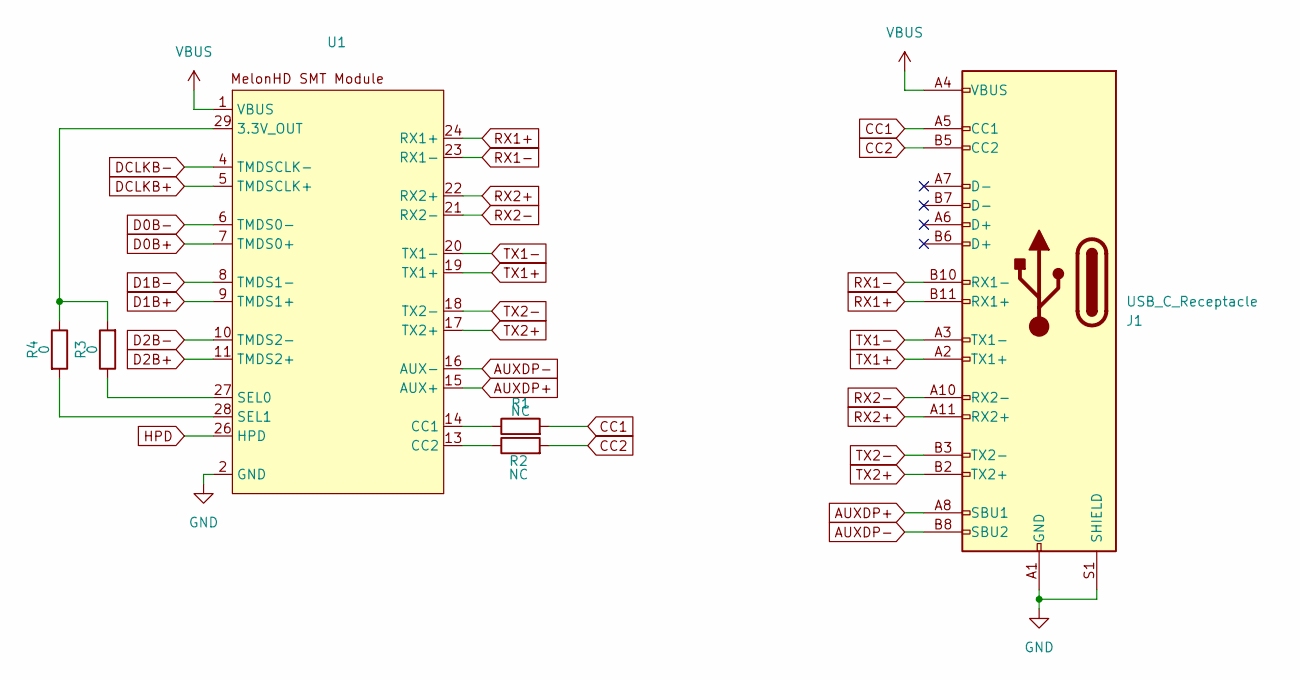
[picture p32: schematic melon_dh.kicad_sch]

Parts:
J1: USB_C_Receptacle; USB_C_Receptacle_Amphenol_12401610E4-2A
R1, R2: NC; R_0201_0603Metric
R3, R4: 0; R_0201_0603Metric
U1: melonHD_SMT

Connections:
AUXDP+: J1.A8 (SBU1), U1.15 (AUX+)
AUXDP-: J1.B8 (SBU2), U1.16 (AUX-)
CC1: J1.A5 (CC1), R1.2
CC2: J1.B5 (CC2), R2.2
D0B+: U1.7 (TMDS0+)
D0B-: U1.6 (TMDS0-)
D1B+: U1.9 (TMDS1+)
D1B-: U1.8 (TMDS1-)
D2B+: U1.11 (TMDS2+)
D2B-: U1.10 (TMDS2-)
DCLKB+: U1.5 (TMDSCLK+)
DCLKB-: U1.4 (TMDSCLK-)
GND: J1.A1 (GND), J1.A12 (GND), J1.B1 (GND), J1.B12 (GND), J1.S1 (SHIELD), U1.2 (GND), U1.3 (GND), U1.12 (GND), U1.25 (GND), U1.30 (GND), U1.31 (GND)
HPD: U1.26 (HPD)
unnamed: R1.1, U1.14 (CC1)
unnamed: R2.1, U1.13 (CC2)
unnamed: R3.1, U1.27 (SEL0)
unnamed: R3.2, R4.1, U1.29 (3.3V_OUT)
unnamed: R4.2, U1.28 (SEL1)
RX1+: J1.B11 (RX1+), U1.24 (RX1+)
RX1-: J1.B10 (RX1-), U1.23 (RX1-)
RX2+: J1.A11 (RX2+), U1.22 (RX2+)
RX2-: J1.A10 (RX2-), U1.21 (RX2-)
TX1+: J1.A2 (TX1+), U1.19 (TX1+)
TX1-: J1.A3 (TX1-), U1.20 (TX1-)
TX2+: J1.B2 (TX2+), U1.17 (TX2+)
TX2-: J1.B3 (TX2-), U1.18 (TX2-)
VBUS: J1.A4 (VBUS), J1.A9 (VBUS), J1.B4 (VBUS), J1.B9 (VBUS), U1.1 (VBUS)
