RoseDaggerDev/GBAWii3-Boards/MelonLORD/KiCad/sd_card.kicad_sch

## KiCad design MelonLORD/KiCad/sd_card.kicad_sch (2025-09-04)

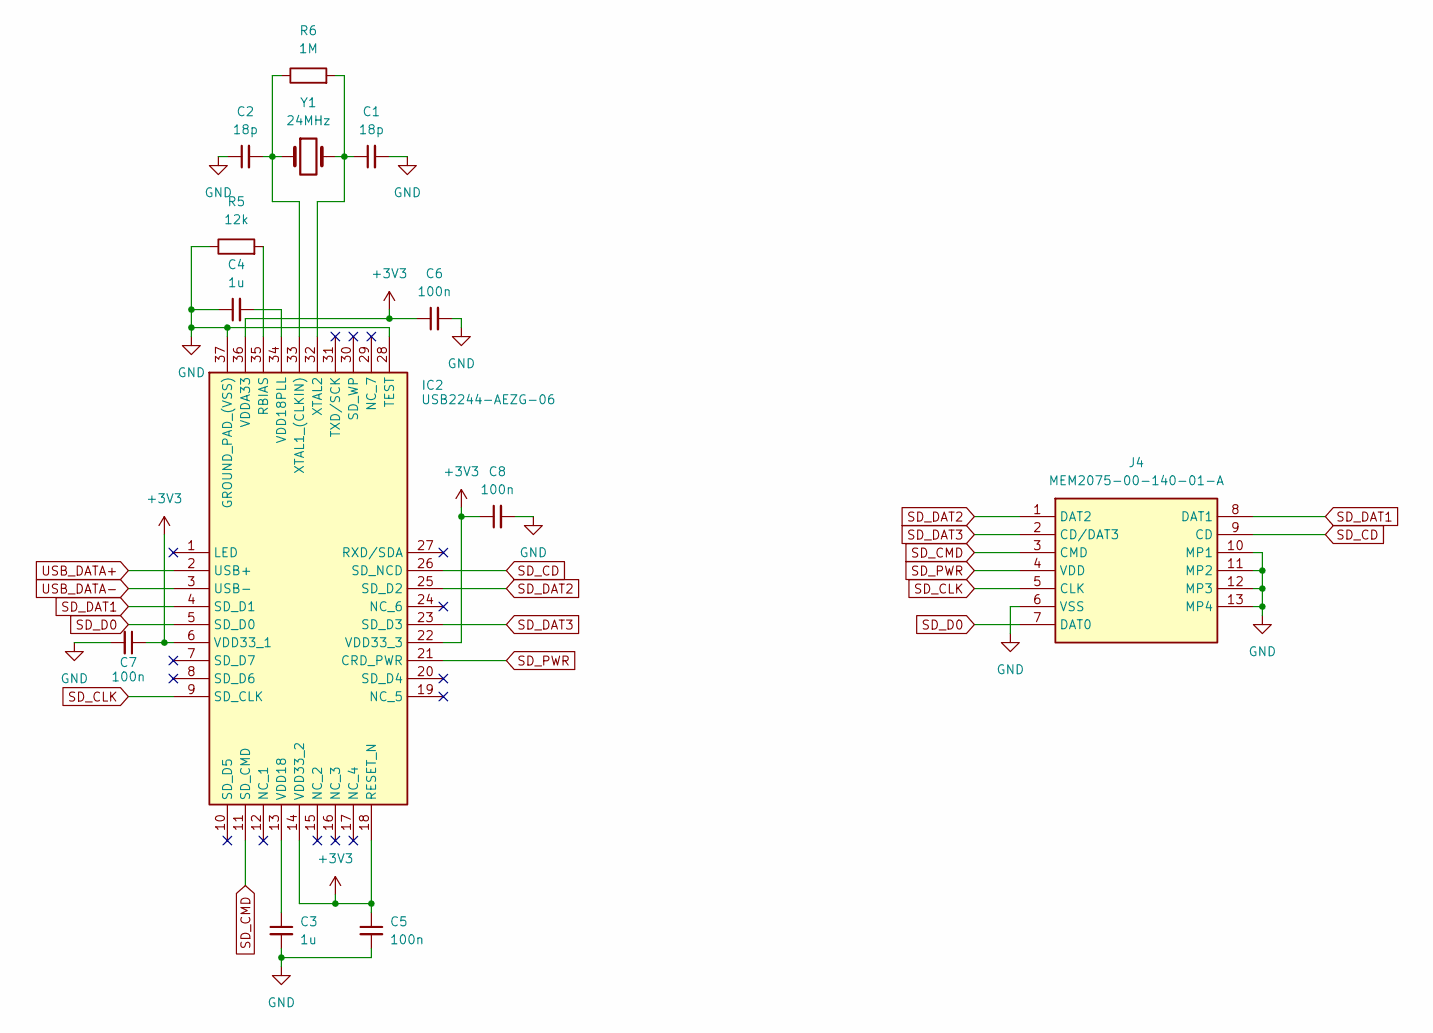
[picture p33: schematic sd_card.kicad_sch]

Parts:
C1, C2: 18p; C_0402_1005Metric
C3, C4: 1u; C_0603_1608Metric
C5, C6, C7, C8: 100n; C_0402_1005Metric
IC2: USB2244-AEZG-06; QFN50P600X600X90-37N; Mouser Part Number 886-USB2244-AEZG-06
J4: MEM2075-00-140-01-A; MEM20750014001A; Mouser Part Number 640-MEM20750014001A
R5: 12k; R_0402_1005Metric
R6: 1M; R_0402_1005Metric
Y1: 24MHz; Crystal_SMD_MicroCrystal_CM9V-T1A-2Pin_1.6x1.0mm

Connections:
+3V3: C5.1, C6.1, C7.1, C8.1, IC2.6 (VDD33_1), IC2.14 (VDD33_2), IC2.18 (RESET_N), IC2.22 (VDD33_3), IC2.36 (VDDA33)
GND: C1.2, C2.1, C3.2, C4.1, C5.2, C6.2, C7.2, C8.2, IC2.28 (TEST), IC2.37 (GROUND_PAD_(VSS)), J4.6 (VSS), J4.10 (MP1), J4.11 (MP2), J4.12 (MP3), J4.13 (MP4), R5.1
unnamed: C1.1, IC2.32 (XTAL2), R6.2, Y1.2
unnamed: C2.2, IC2.33 (XTAL1_(CLKIN)), R6.1, Y1.1
unnamed: C3.1, IC2.13 (VDD18)
unnamed: C4.2, IC2.34 (VDD18PLL)
unnamed: IC2.35 (RBIAS), R5.2
SD_CD: IC2.26 (SD_NCD), J4.9 (CD)
SD_CLK: IC2.9 (SD_CLK), J4.5 (CLK)
SD_CMD: IC2.11 (SD_CMD), J4.3 (CMD)
SD_D0: IC2.5 (SD_D0), J4.7 (DAT0)
SD_DAT1: IC2.4 (SD_D1), J4.8 (DAT1)
SD_DAT2: IC2.25 (SD_D2), J4.1 (DAT2)
SD_DAT3: IC2.23 (SD_D3), J4.2 (CD/DAT3)
SD_PWR: IC2.21 (CRD_PWR), J4.4 (VDD)
USB_DATA+: IC2.2 (USB+)
USB_DATA-: IC2.3 (USB-)
