RoseDaggerDev/GBAWii3-Boards/(commit log)

2025-09-04 Initial push near production ready
    [EastECHO-Edge_Cuts.dxf, EastECHO.kicad_sch, EastECHO.step, EastECHO.stl, GC2Plus.kicad_sch, GhostPAW-B_Mask.dxf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]
2025-09-09 Updated boards to pre production
    [EastECHO-Edge_Cuts.dxf, EastECHO.stl, GhostPAW-Edge_Cuts.dxf, GhostPAW.kicad_sch, GhostPAW.stl, MelonLORD.stl]
